anabrid/the-analog-thing/README.md

# the-analog-thing
Schematics and Gerber Files of the Open Hardware Analog Computer "THE ANALOG THING"
