anabrid/the-analog-thing/ANATHING_OSH/ANATHING-BASE - Schematic.pdf

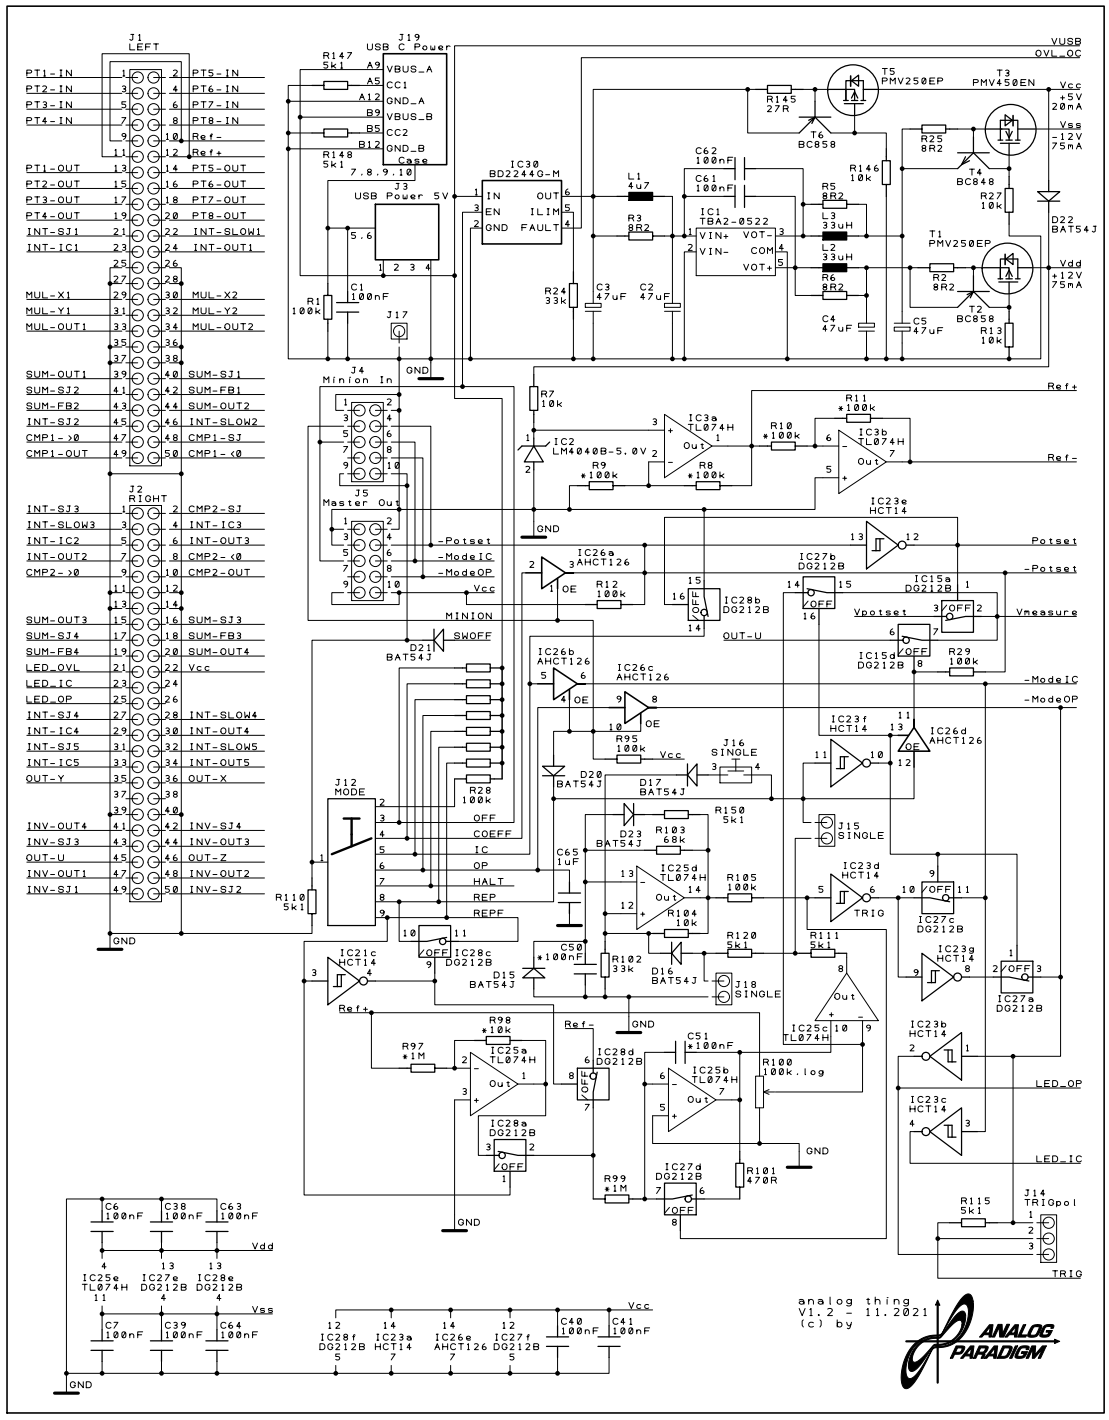
[picture p14: page 1]
