anabrid/the-analog-thing/ANATHING_OSH/ANATHING-BASE - Schematic2.pdf

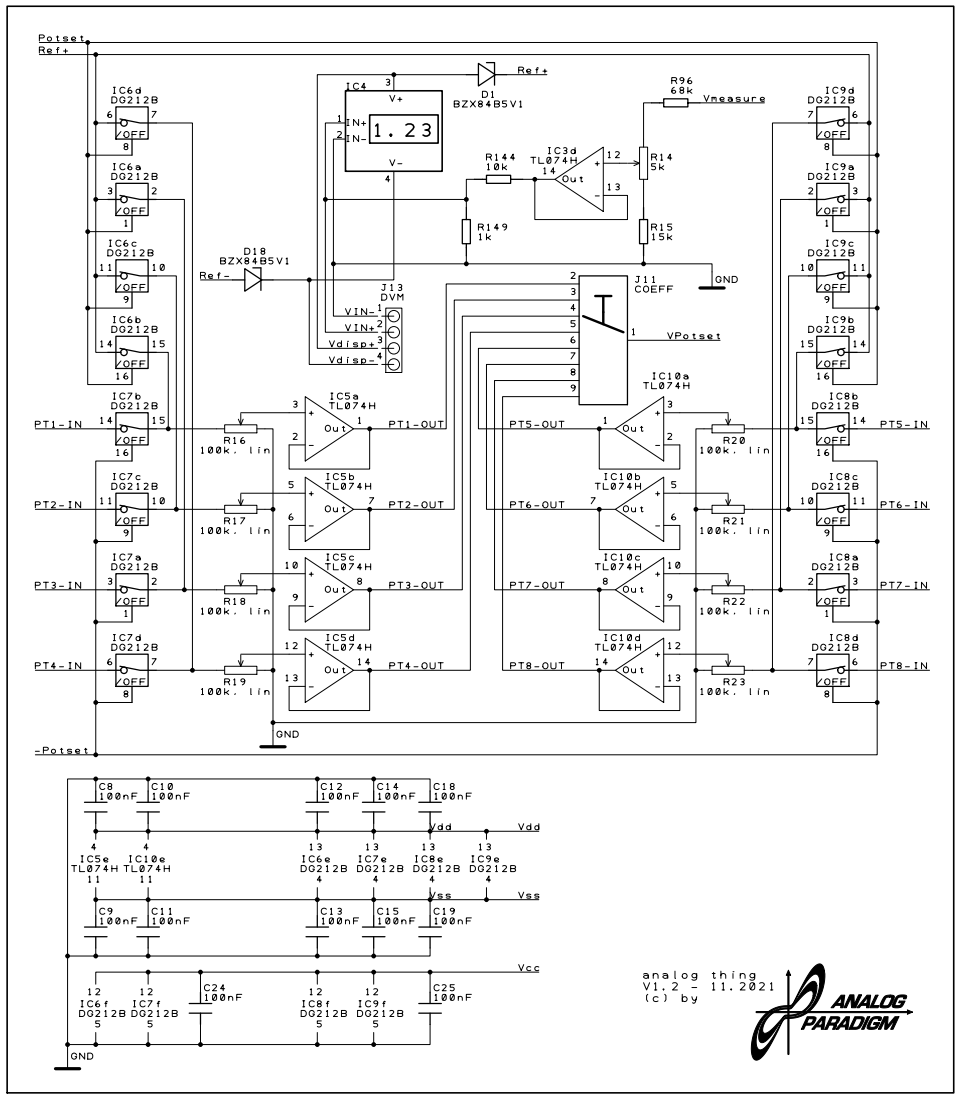
[picture p15: page 1]
