anabrid/the-analog-thing/ANATHING_OSH/ANATHING-BASE - Schematic3.pdf

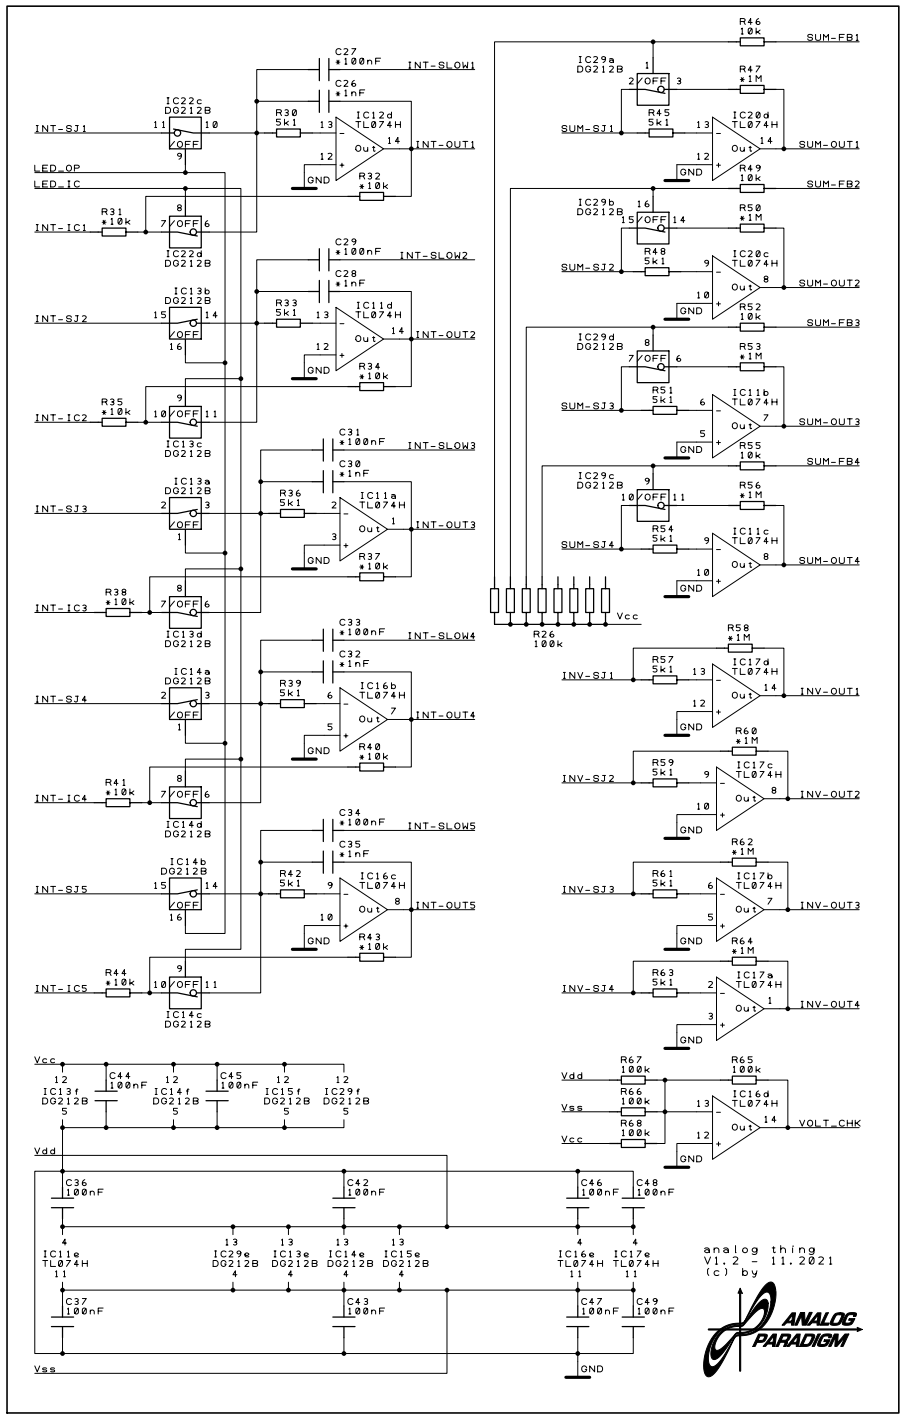
[picture p16: page 1]
