anabrid/the-analog-thing/ANATHING_OSH/ANATHING-BASE - Schematic4.pdf

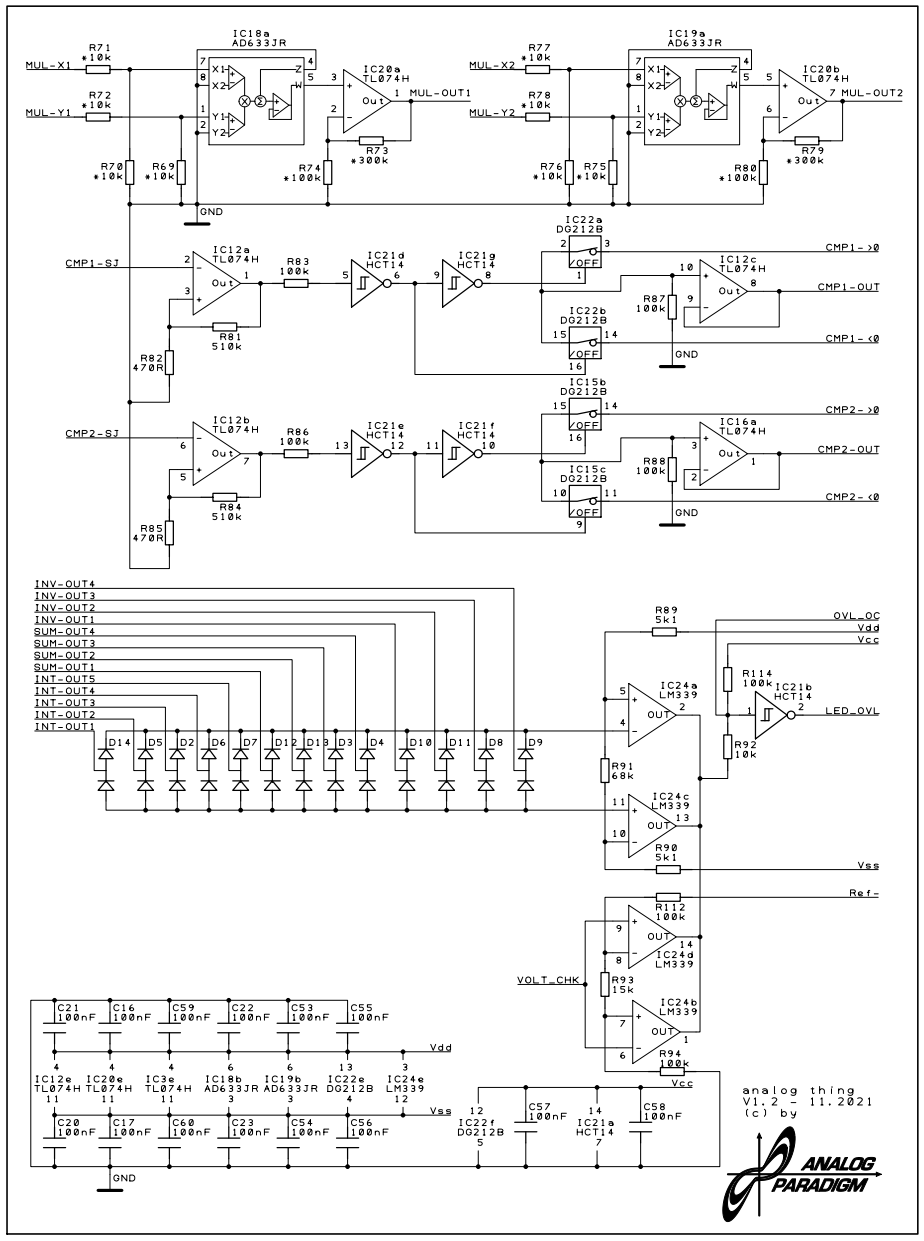
[picture p17: page 1]
