anabrid/the-analog-thing/ANATHING_OSH/ANATHING-BASE - Schematic5.pdf

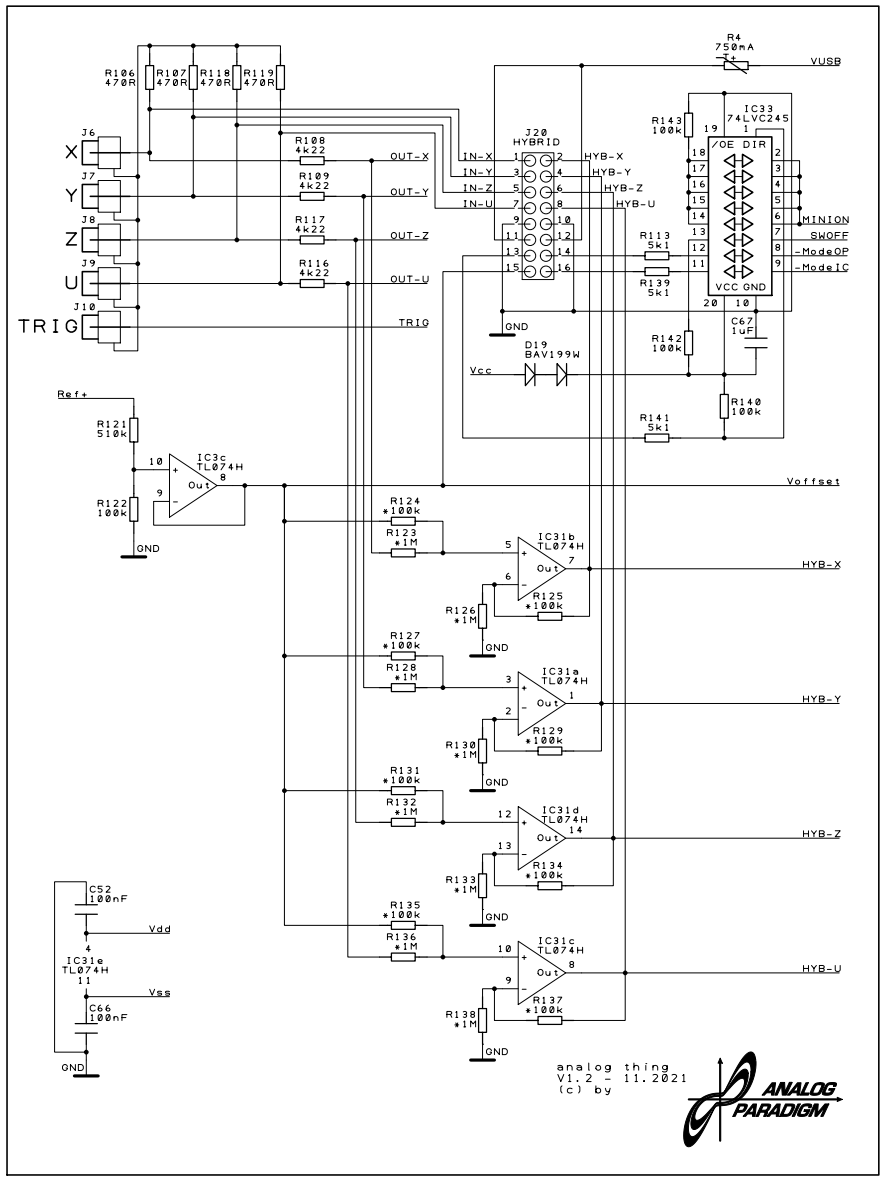
[picture p18: page 1]
