anabrid/the-analog-thing/ANATHING_OSH/ANATHING-FRONT - Schematic.pdf

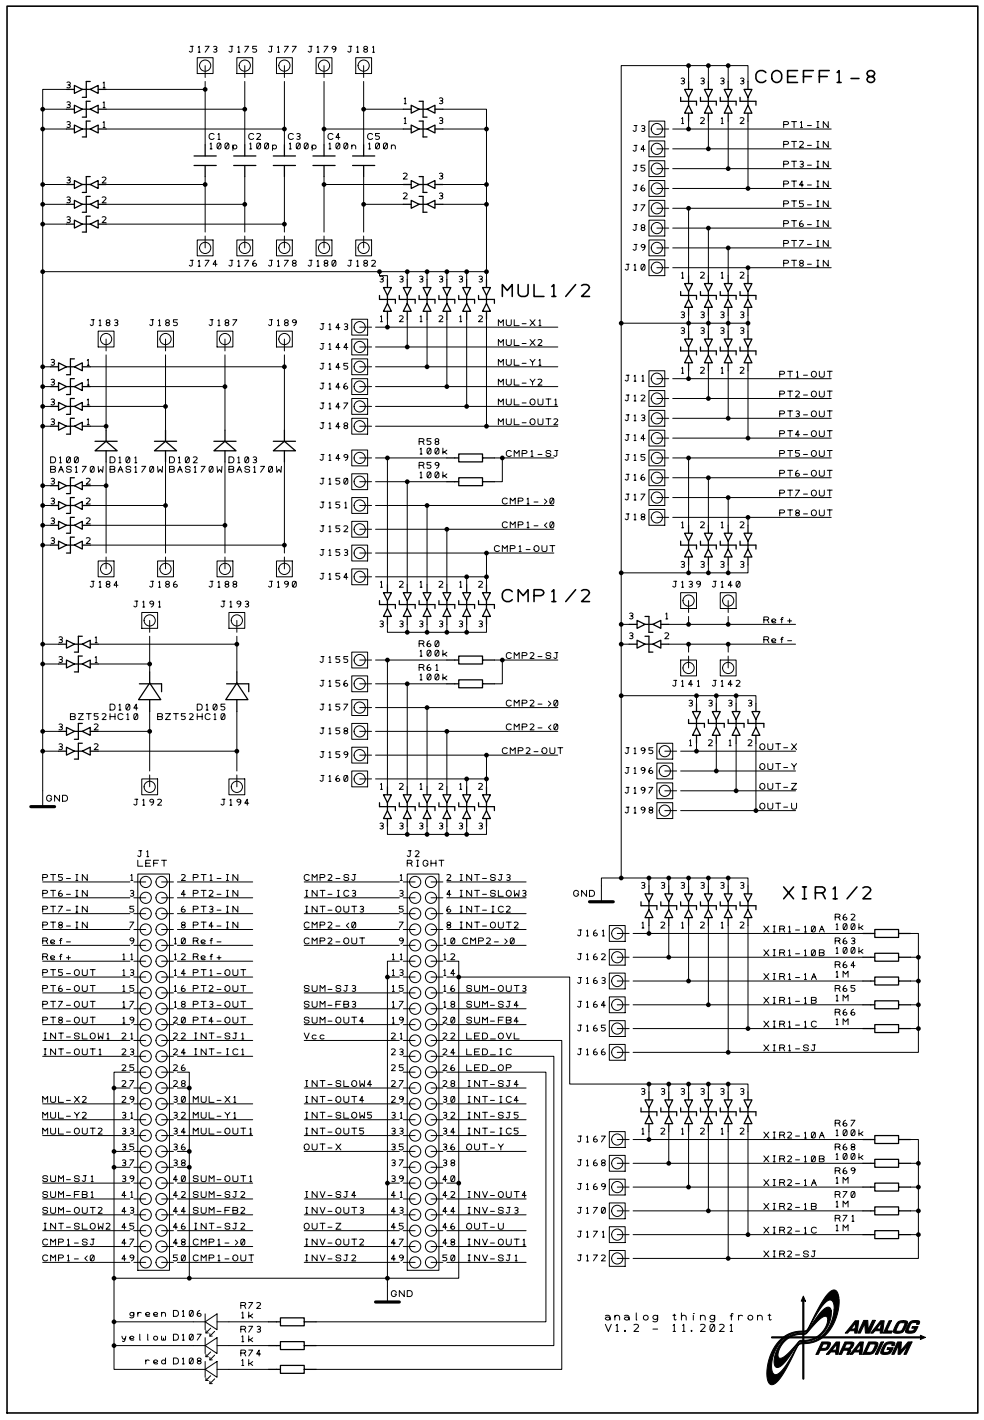
[picture p19: page 1]
