anabrid/the-analog-thing/ANATHING_OSH/ANATHING-FRONT - Schematic2.pdf

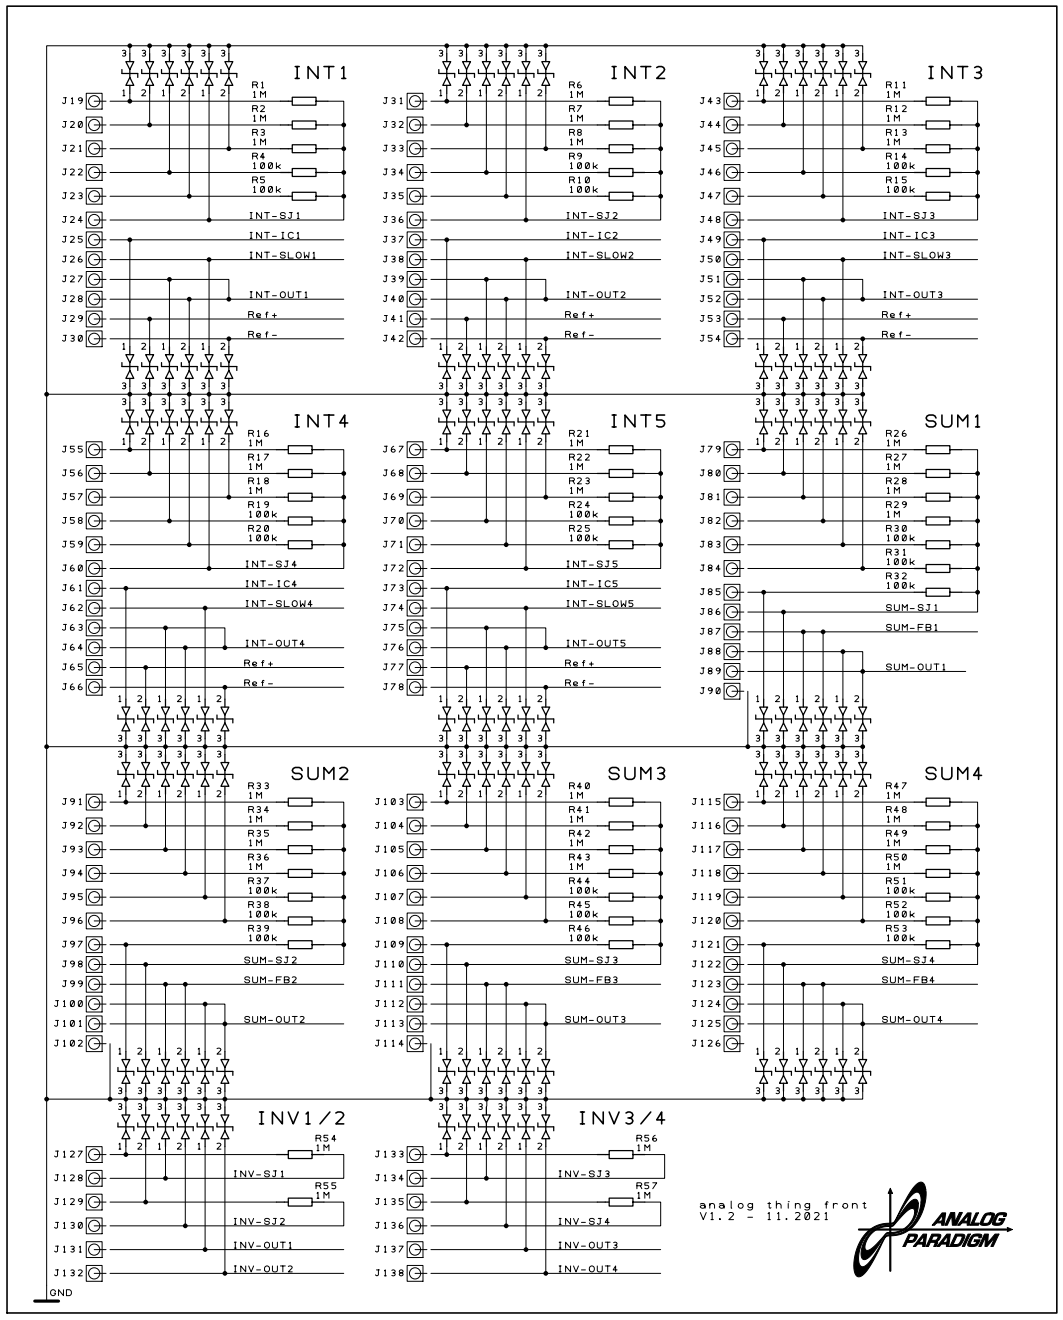
[picture p20: page 1]
