anabrid/the-analog-thing/(list of files, drawings)

Other design files:
ANATHING_OSH/ANATHING_OSH_pcbdata/ANATHING-BASE_OSH.pcb
ANATHING_OSH/ANATHING_OSH_pcbdata/ANATHING-FRONT_OSH.pcb
