anabrid/the-analog-thing/(commit log)

2022-03-14 ANATHING_OSH.zip von KH Version 03.03.2022
    [ANATHING-BASE (BOM)_20211129.csv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]
2022-07-31 Add files via upload
    These are the same version of the ANATHING-BASE_OSH_V12_production and ANATHING-FRONT_OSH_V12a_production except that there is an additional BoardOutline layer added. The board outlines from all other gerber are removed and there is a little drill hole change for the 4 outer mechanical 3.2mm holes for the screws (which have been as milled structure in the version before). Please be aware, that the ANATHING-FRONT BoardOutline layer does not only contain the outline but also milling structures for the big holes for the potentiometers, switches and the panelmeter. There can not be devided further by the software DesignSpark PCB Pro, as it is usually handled in the same proc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
2023-03-15 CAD files for THAT (designspark)
    [ANATHING-BASE.sch, ANATHING-BASE2.sch, ANATHING-BASE3.sch, ANATHING-BASE4.sch, ANATHING-BASE5.sch, ANATHING-BASE_OSH.pcb, ANATHING-FRONT.sch, ANATHING-FRONT2.sch]
